JonyAlan/TG-Prot-tipo-carro-aut-nomo/Ligações-Imagens/5.png

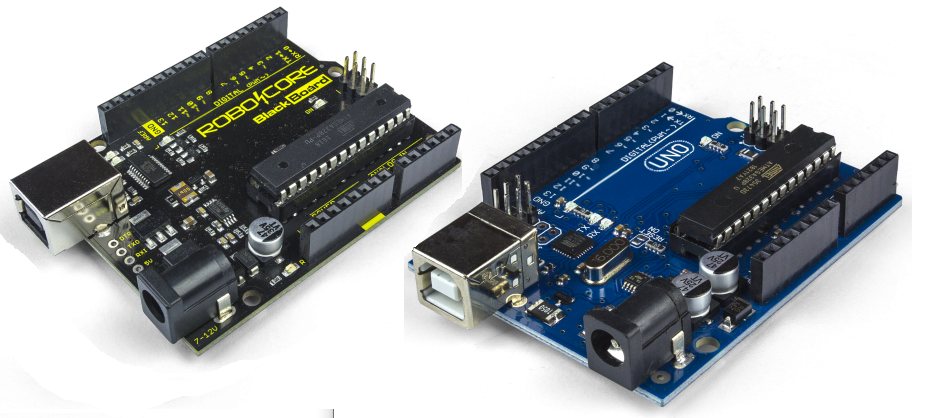
Ligações-Imagens/5.png
