JonyAlan/TG-Prot-tipo-carro-aut-nomo/Ligações-Imagens/2.png

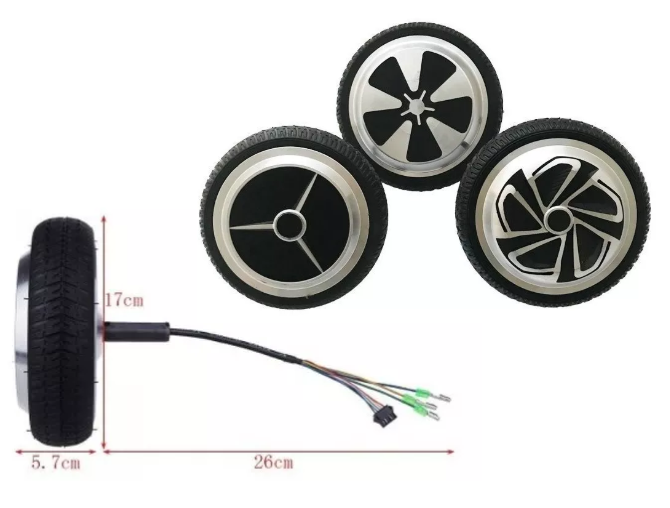
Ligações-Imagens/2.png
