JonyAlan/TG-Prot-tipo-carro-aut-nomo/README.md

Este trabalho tem como objetivo mostrar e documentar as etapas envolvidas no processo de desenvolvimento de um protótipo de carro autônomo, que através de um destino estabelecido consiga calcular sua rota e assim estabelecer uma direção precisa e se deslocar até ela desviando de obstáculos que possam vir a aparecer pelo caminho, tudo isso utilizando equipamentos eletrônicos de baixo custo ou reaproveitados, sendo codificados com bibliotecas de plataformas abertas e software livre, após sucesso em todas as etapas de desenvolvimento, espera-se que os estudos e análises possam ser implementados e melhorados em novos projetos que necessitem de deslocamento sem controle visual, rotas de monitoramento, ou qualquer lugar que não se possa adentrar por algum tipo de obstáculo.

Palavras-chave: Módulo GPS; Bússola eletrônica, Autonomia, Monitoramento, Desvio de obstáculos, Sensores, Arduino, Cálculo de rotas, Tomada de decisão
