JonyAlan/TG-Prot-tipo-carro-aut-nomo/Technology Roadmap-creative.pptx

Veículo autônomo guiado por coordenadas GPS


Trabalho de graduação

Jony Alan de C. Nunes

Dezembro 2019

## Slide 2

Como dirigimos ?

Criar um mapa mental da origem

Definiir um destino

Escolher uma rota

Evitar obstaculos /Recalcular o caminho

## Slide 3

Carro autônomo

Identiicar localização

Identiicar destino

Calcular rota

Evitar obstaculos /Recalcular o caminho

Autônomia

Limitações

Protótipo

Notes: Autónomo => Veículo que pudesse se locomover de um ponto á outro sem interferencia humana
Limitações => (recursos limitados) Não seria possível nem viavel começar a desenvolver em cima de um carro de verdade
Protótipo => Veículo com uma escala bem menor com custos mais baixos e com alterações mais customizadas

## Slide 4

Posicionamento

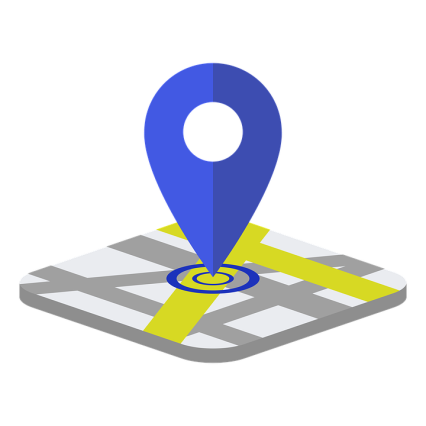
[picture p18: figure]
Gps, Cor, Procura, Mapa, On-Line, Tecnologia, Ícone

Início do percurso

Latitude: -23.480395

Longitude: -47.425745

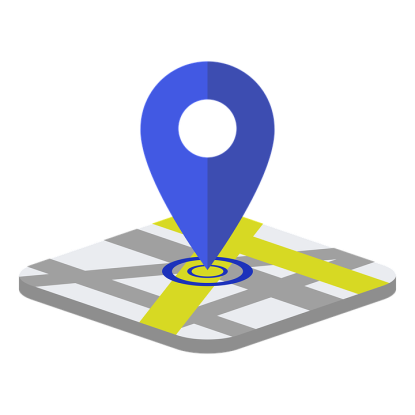
[picture p19: figure]
Gps, Cor, Procura, Mapa, On-Line, Tecnologia, Ícone

Fim do percurso

Notes: - COMO ?

## Slide 5

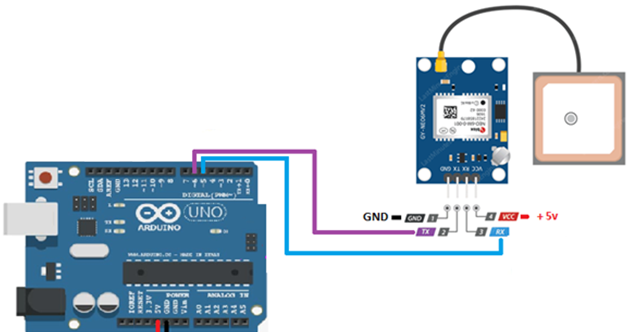
[picture p20: figure]

Posicionamento

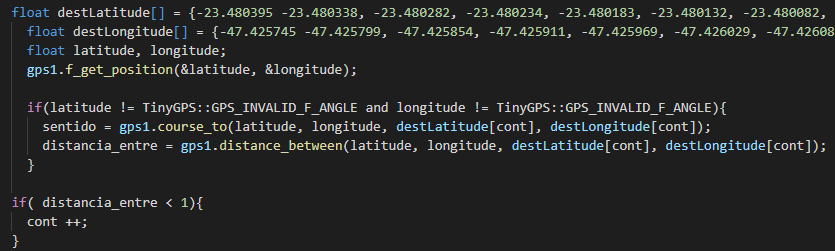
[picture p21: figure]

## Slide 6

Direção

33.75°

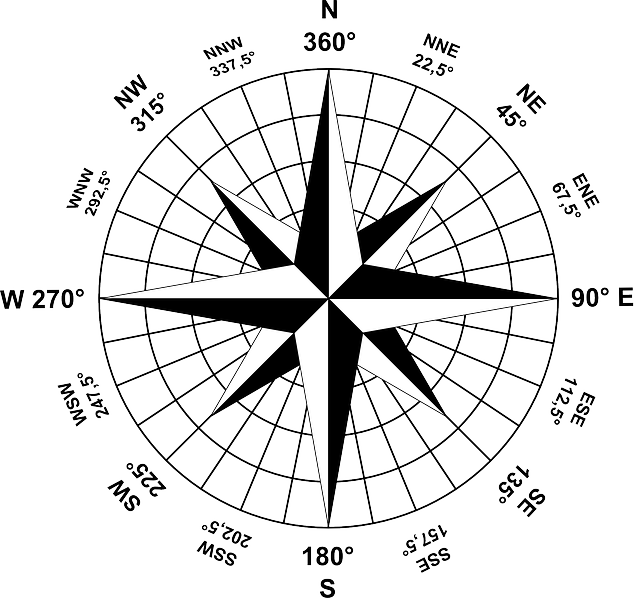
[picture p22: figure]
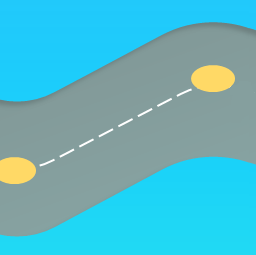
[picture p23: figure]

-56.25°

90°

Origem: 90°

- Destino: 33.75°

56.25°

Notes: - COMO ?

## Slide 7

Direção

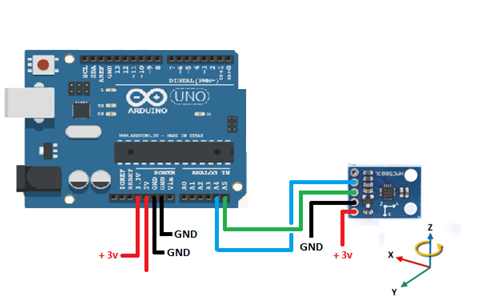
[picture p24: figure]
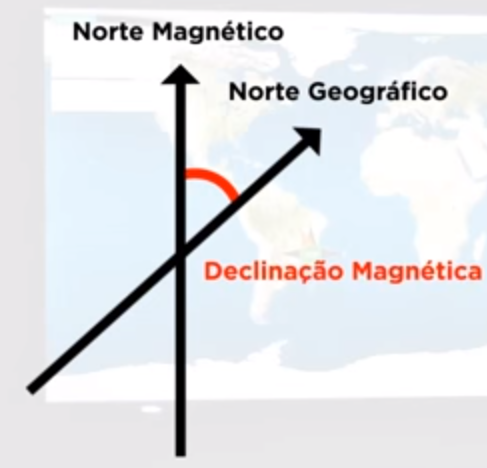
[picture p25: figure]

## Slide 8

Motores

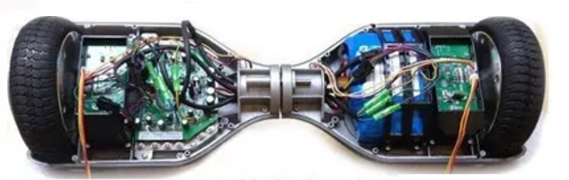
[picture p26: figure]
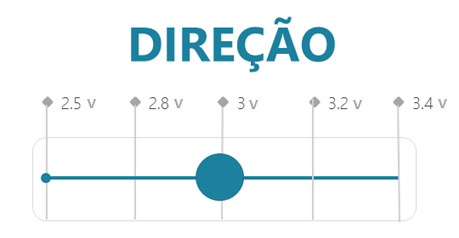
[picture p27: figure]
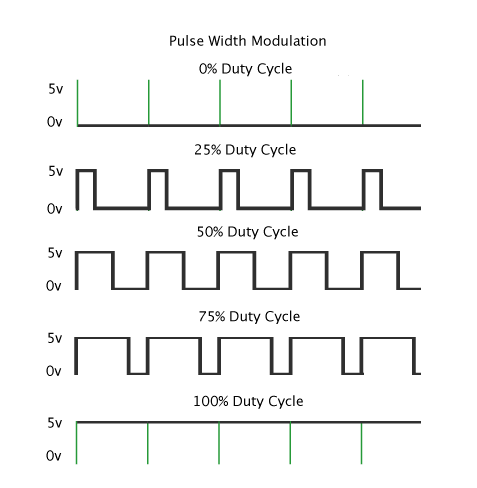
[picture p28: figure]

Precisão

Autonômia

Custo

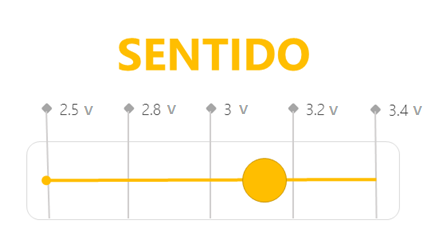
[picture p29: figure]

Notes: PWM –
Ligação de 2 arduinos

## Slide 9

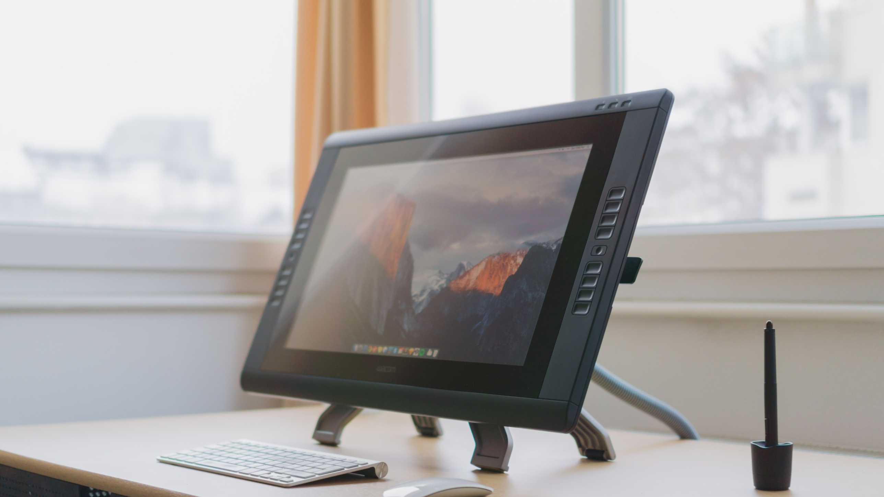
[picture p30: figure]

Melhorias

IA para desvios de obstáculos

Maior poder de processamento

Calibração dos destinos

Notes: Uber
OCR – PITHERACT- GOOGLE(API Vision e o AutoML Vision)

## Slide 10

Veículo autônomo

Antes

Antes

Depois

Depois

IARA

Meu projeto

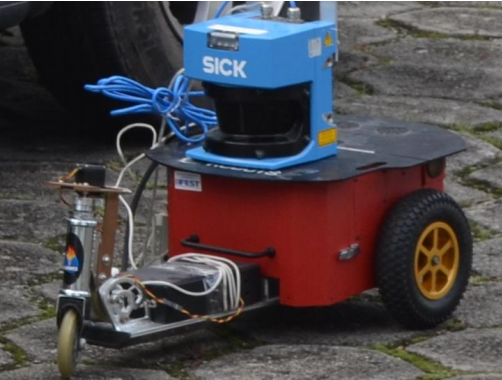
[picture p31: figure]
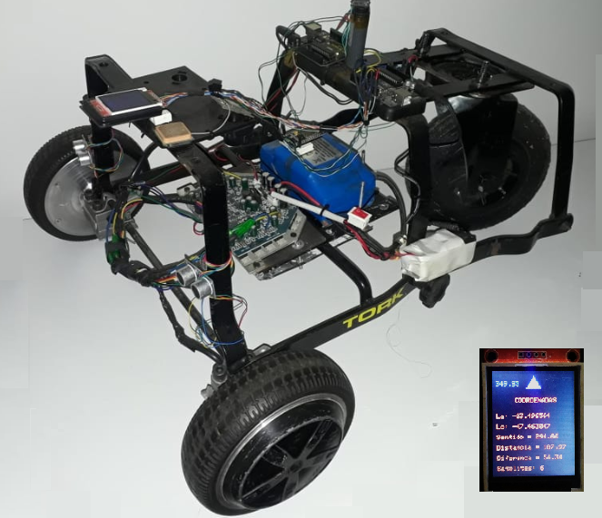
[picture p32: figure]
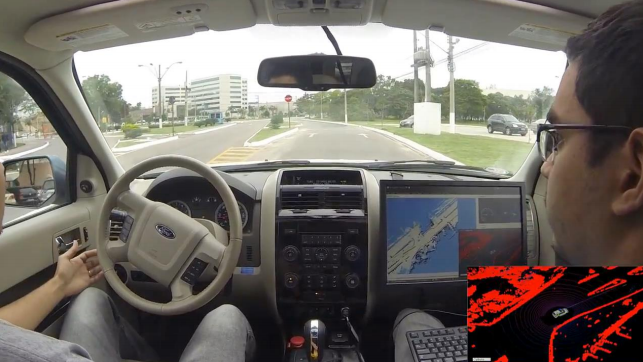
[picture p33: figure]
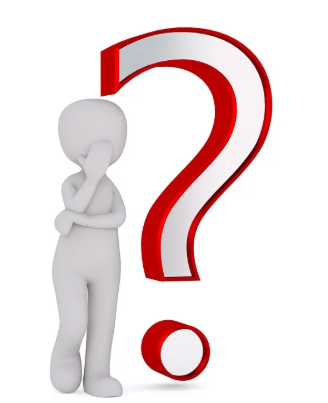
[picture p34: figure]

Notes: Iara (Intelligent Autonomous Robotic Automobile), 2009. UfES

## Slide 11

Obrigado !
