JonyAlan/TG-Prot-tipo-carro-aut-nomo/Código-Arduinos/gps_bússola_display.c

//Coordenadas, sentido e display
#include <SoftwareSerial.h>
#include <TinyGPS.h>
#include <Wire.h>
#include <HMC5883L.h>
#include <SPI.h>
#include <Adafruit_GFX.h>    // Core graphics library
#include <Adafruit_ST7735.h> // Hardware-specific library

#define TFT_CS     10 // azul
#define TFT_RST    8  // verde
#define TFT_DC     9 // azul

Adafruit_ST7735 tft = Adafruit_ST7735(TFT_CS,  TFT_DC, TFT_RST); // Instância do objeto tipo Adafruit_ST7735 que recebe como argumentos os pinos de controle
SoftwareSerial serial1(5, 6); // RX Azul, TX Verde
TinyGPS gps1;
HMC5883L compass;

float sentido;
float distancia_entre;
int i; //Variável para contagem
int cont = 0; //Variável para controle de latitudee longitde
float headingDegrees;
float declinationAngle;
//float precisao; //Variável parar o melhorar a precisao do valor aferido
bool recebido = false;
String sentidotxt = "";


void setup() {
  serial1.begin(9600);
  Serial.begin(9600);
  //Define as configurações iniciais do display
  tft.setCursor(15,15); // Move o cursor para a coluna 30 na linha 0 
  tft.initR(INITR_BLACKTAB); // Inicializa a tela com um fundo preto
  tft.setTextSize(2); // Seta o tamanho da fonte de texto para o tamanho 2
  tft.fillScreen(ST7735_BLACK); // Preenche a tela com a cor preta
  tft.setTextColor(ST7735_BLUE); // Seta a cor do texto para Azul
  tft.println("Fatec-SO");//Escreve no display
  tft.println(" ");//Escreve no display
  tft.setCursor(0,80); // Move o cursor para a coluna 30 na linha 0 
  tft.fillRect(85, 40, 58, 20, ST7735_BLACK);
  tft.setTextColor(ST7735_RED); 
  tft.println("Loading");

  for(i = 0; i < 7 ; i++){
  tft.setCursor(85,80); // Move o cursor para a coluna 30 na linha 0 
  tft.fillRect(85, 80, 58, 20, ST7735_BLACK);
  tft.setTextColor(ST7735_RED); 
  delay(250);
  tft.setCursor(85,80); // Move o cursor para a coluna 30 na linha 0 
  tft.fillRect(85, 80, 58, 20, ST7735_BLACK);
  tft.setTextColor(ST7735_RED); 
  tft.println(".");
  delay(250);
  tft.setCursor(85,80);
  tft.fillRect(85, 80, 58, 20, ST7735_BLACK);
  tft.setTextColor(ST7735_RED); 
  tft.println("..");
  delay(250);
  tft.setCursor(85,80);
  tft.fillRect(85, 80, 58, 20, ST7735_BLACK);
  tft.setTextColor(ST7735_RED); 
  tft.println("...");
  delay(250);
  }
  //tft.drawTriangle(20, 120, 120, 120, 160, 120, ST7735_BLUE);
  tft.setTextSize(1); // Seta o tamanho da fonte de texto para o tamanho 2
  tft.fillScreen(ST7735_BLACK); // Preenche a tela com a cor preta
    
  compass.setRange(HMC5883L_RANGE_1_3GA);
  compass.setMeasurementMode(HMC5883L_CONTINOUS);
  compass.setDataRate(HMC5883L_DATARATE_30HZ);
  compass.setSamples(HMC5883L_SAMPLES_8);
  compass.setOffset(0, 0);

  // Para Sorocaba-SP, o ângulo de declinação é 21'2W (positivo)
  // Fórmula: (deg + (min / 60,0)) / (180 / M_PI);
  float decinationAngle = ( 4.0 + ( 26.0 / 60.0 )) / ( 180 / M_PI);
}

void loop(){
  static unsigned long delayPrint;
  // Correct for heading < 0deg and heading > 360deg
//precisao = 0;
//for(i = 0; i < 20 ; i++){ //Faz a leitura 50 e armazenar a somatória

  Vector norm = compass.readNormalize();
  float heading = atan2(norm.YAxis, norm.XAxis);
  
  heading += declinationAngle;
  //Converte o valor aferido para angulo
  if (heading < 0){
    heading += 2 * PI;
  }
  if (heading > 2 * PI){
    heading -= 2 * PI;
  }
  headingDegrees = heading * 180/M_PI;

   int graus = (int) headingDegrees;

  while (serial1.available()) {
    char cIn = serial1.read();
    recebido = (gps1.encode(cIn) || recebido); 
  }
  
  tft.setCursor(0,15); // Move o cursor para a coluna 30 na linha 0
  tft.setTextColor(ST7735_BLUE);
  tft.fillRect(0,0, 50, 28, ST7735_BLACK);
  tft.print(" ");
  tft.println(headingDegrees);
  tft.fillTriangle(53,25, 64, 7, 75, 25, ST7735_BLUE);
  
  if (recebido){ 
      
	float destLatitude[] = {-23.480395 -23.480338, -23.480282, -23.480234, -23.480183, -23.480132, -23.480082, -23.480031 };
    float destLongitude[] = {-47.425745 -47.425799, -47.425854, -47.425911, -47.425969, -47.426029, -47.426087, -47.426145 };
    float latitude, longitude;
    gps1.f_get_position(&latitude, &longitude); 
	
    if(latitude != TinyGPS::GPS_INVALID_F_ANGLE and longitude != TinyGPS::GPS_INVALID_F_ANGLE){
      sentido = gps1.course_to(latitude, longitude, destLatitude[cont], destLongitude[cont]);
      distancia_entre = gps1.distance_between(latitude, longitude, destLatitude[cont], destLongitude[cont]);
    }
	
	if( distancia_entre < 1){
		cont ++;
	}
	
    //Configuração do display 
    float diferenca;
    diferenca = graus - sentido;
    String postComp = "";
    if(abs(diferenca) < 5){
       postComp = "C";
    }else{
      if(diferenca < 0 and (diferenca * -1) < 180 ){
        postComp = "D";
      }
      if(diferenca < 0 and (diferenca * -1) > 180 ){
        postComp = "E";
      }
      if(diferenca > 0 and diferenca < 180 ){
        postComp = "E";
      }
      if(diferenca > 0 and diferenca > 180 ){
        postComp = "D";
      }
    } 
      Serial.println("F");
      Serial.println(postComp);
   
    tft.setTextColor(ST7735_RED);
    tft.setCursor(28,40); // Move o cursor para a coluna 30 na linha 0 
    //Mensagens enviadas ao display
    tft.println(" COORDENADAS");
    //A função drawRect é responsável por desenhar um retângulo na tela, passando um ponto de origem, sua largura e altura.
    tft.fillRect(0, 60, 128, 100, ST7735_BLACK);
    tft.println("");
    tft.println("");
    tft.print(" La: ");
    tft.println(latitude, 6);
    tft.println("");
    tft.print(" Lo: "); 
    tft.println(longitude, 6);
    tft.println("");
    tft.print(" Sentido = ");
    tft.println(sentido);
    tft.println("");
    tft.print(" Distancia = ");
    tft.println(distancia_entre);
    tft.println("");
    tft.print(" Diferenca = ");
    tft.println(diferenca);
    //satelites 
    unsigned short satelites;  
    satelites = gps1.satellites();  
    // if(satelites != TinyGPS::GPS_INVALID_SATELLITES) {
       tft.println("");
       tft.print(" Satelites: ");
       tft.println(satelites);
    // }
  } 
}
