JonyAlan/TG-Prot-tipo-carro-aut-nomo/(commit log)

2019-05-17 Aprimoramento e correção de falhas do projeto.
2019-05-22 aprimoramento do projeto de TG
    Adicionado comando de comunicação com um segundo arduino, responsável pela direção.
2019-06-20 Controle de velocidade dos motores do hoverboard, frente e ré
2019-06-21 sentido e velocidades
2019-09-12 Alteracão de velocidade e angulo
